szdiy/punch-tape-reader/README.md

# punch-tape-reader

1. /hardware - hardware design files
2. paper_tape_reader.ino - Arduino program for reading paper tape to keyboard

Refs: todo
