szdiy/punch-tape-reader/hardware/shell/1mm.dxf

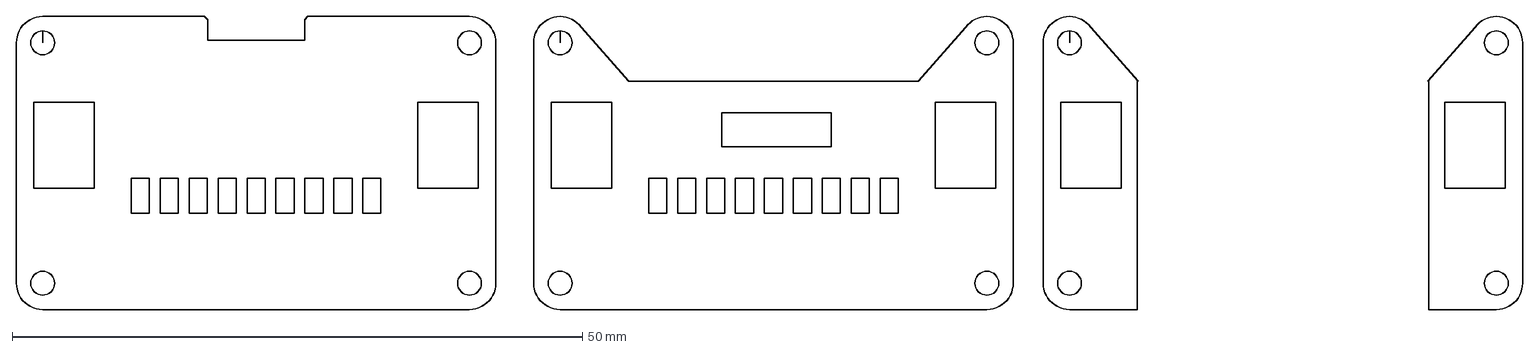
[picture p1: CAD file, 2024-11-14]
hardware/shell/1mm.dxf
132.1 x 25.7 mm
