szdiy/punch-tape-reader/(list of files, cad)

Other CAD files:
hardware/shell/1mm.dwg
