szdiy/punch-tape-reader/hardware/LEDshield.pdf

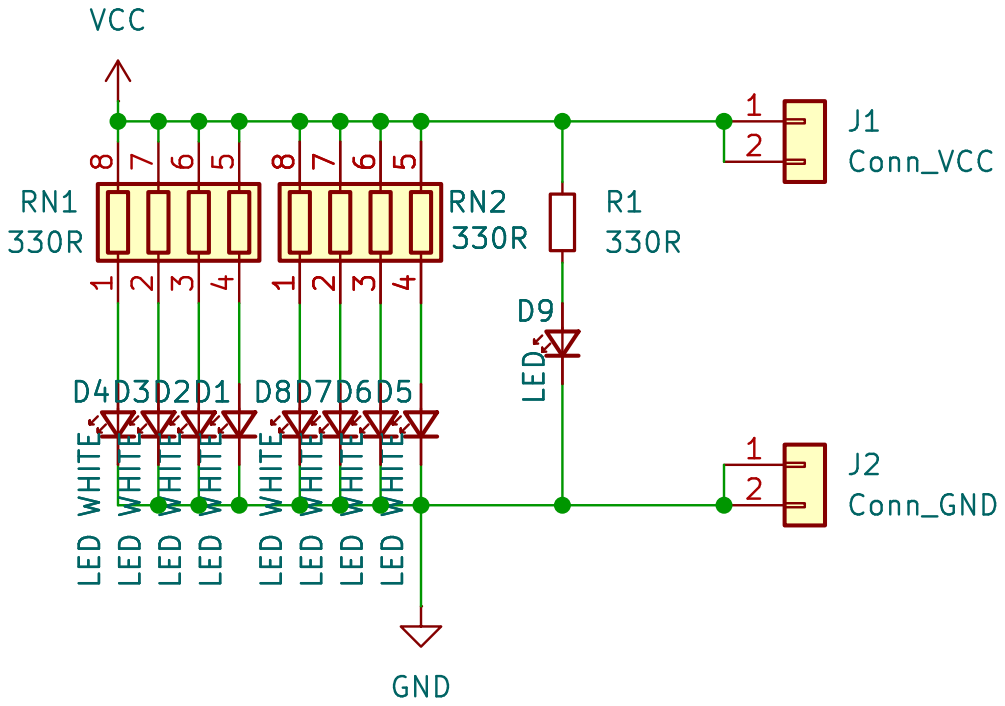
[picture p2: page 1]

5 D5LED WHITE D7LED WHITE D1LED WHITE D6LED WHITE D8LED WHITE D4LED WHITE D2LED WHITE D3LED WHITE

Id: 1/1 Title: File: LEDshield.kicad_sch Sheet: /
