szdiy/punch-tape-reader/hardware/ptr.pdf

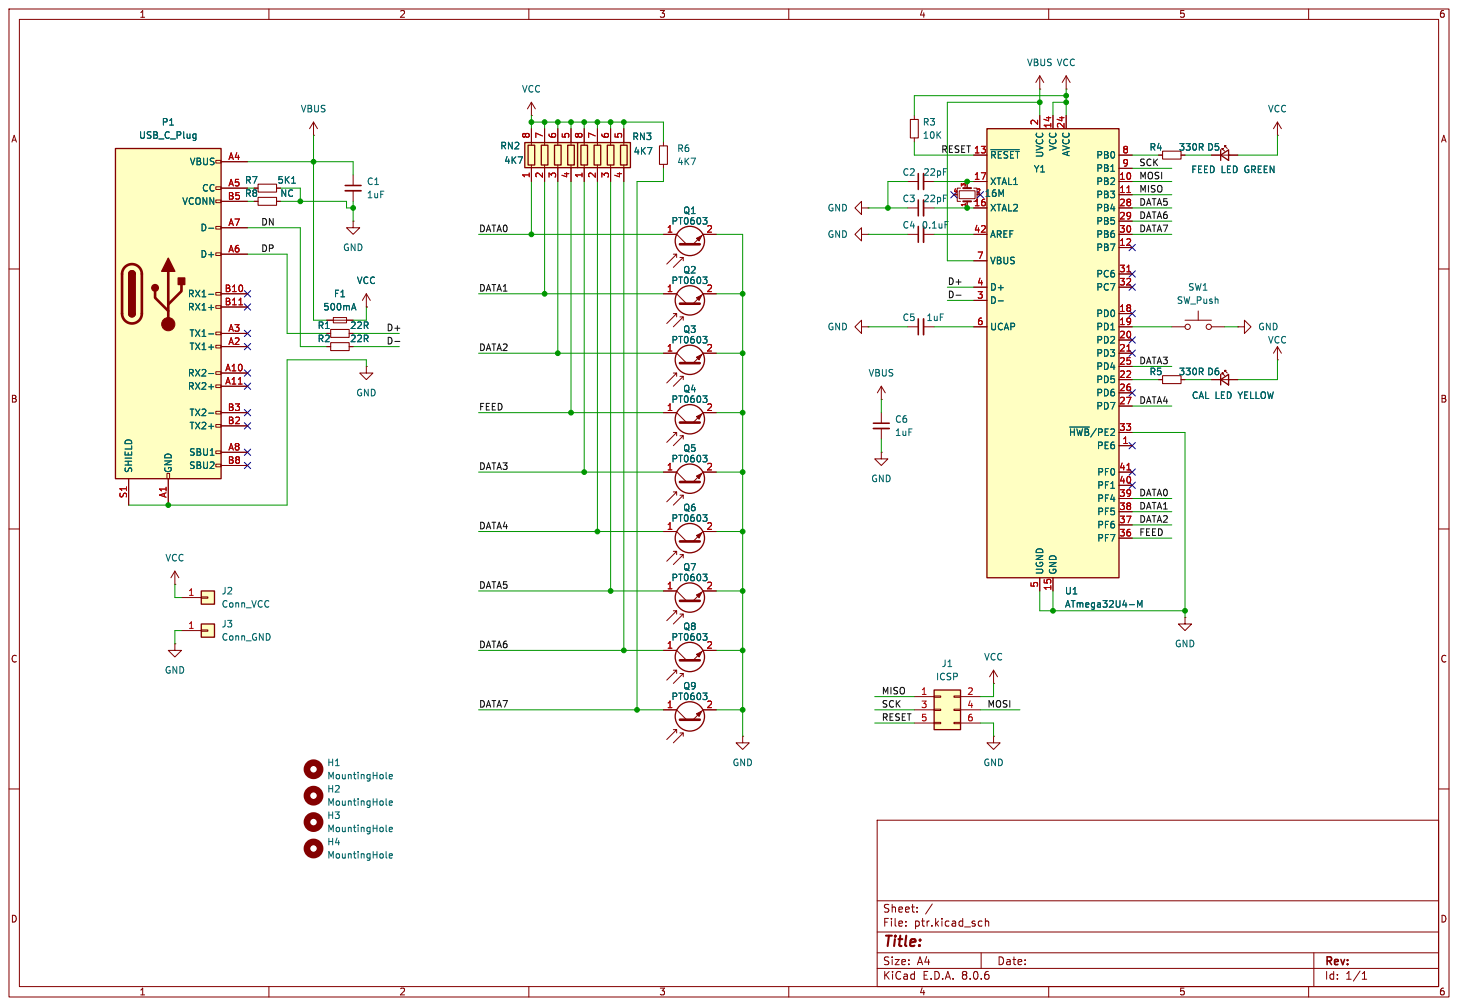
[picture p3: page 1]
