szdiy/punch-tape-reader/hardware/LEDshield.kicad_pcb

## KiCad design hardware/LEDshield.kicad_pcb (2024-11-14)

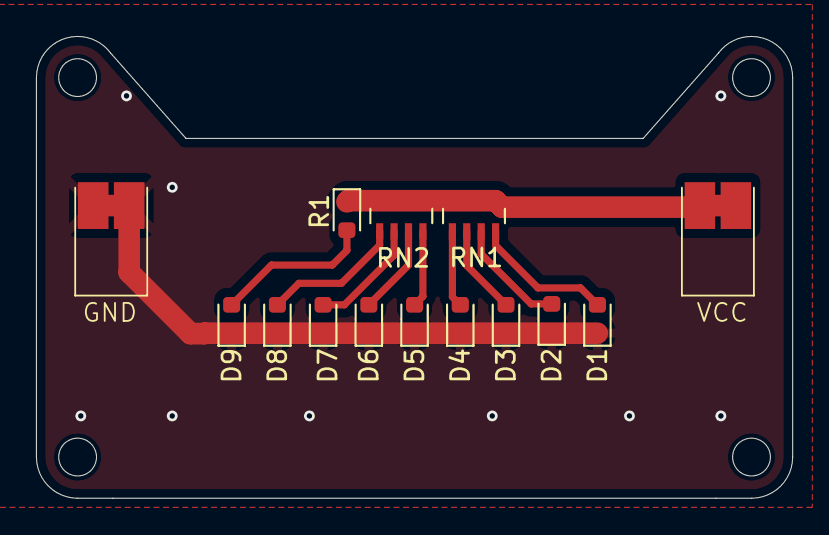
[picture p4: board LEDshield.kicad_pcb from above]

Board: 2 copper layers, 42.0 x 25.7 mm, 18 parts (0 on the bottom side), 11 nets.

Parts:
D1, D2, D3, D4, D5, D6, D7, D8, D9: LED; LED_0603_1608Metric
H1, H2, H3, H4: MountingHole; MountingHole_2.1mm
J1: Conn_VCC; 2pin
J2: Conn_GND; 2pin
R1: 330R; LED_0603_1608Metric
RN1, RN2: 330R; R_Array_Concave_4x0603

Connections:
GND: D1.1 (K), D2.1 (K), D3.1 (K), D4.1 (K), D5.1 (K), D6.1 (K), D7.1 (K), D8.1 (K), D9.1 (K), J2.1, J2.2
unnamed: D1.2 (A), RN1.4 (R4.1)
unnamed: D2.2 (A), RN1.3 (R3.1)
unnamed: D3.2 (A), RN1.2 (R2.1)
unnamed: D4.2 (A), RN1.1 (R1.1)
unnamed: D5.2 (A), RN2.4 (R4.1)
unnamed: D6.2 (A), RN2.3 (R3.1)
unnamed: D7.2 (A), RN2.2 (R2.1)
unnamed: D8.2 (A), RN2.1 (R1.1)
unnamed: D9.2 (A), R1.2
VCC: J1.1, J1.2, R1.1, RN1.5 (R4.2), RN1.6 (R3.2), RN1.7 (R2.2), RN1.8 (R1.2), RN2.5 (R4.2), RN2.6 (R3.2), RN2.7 (R2.2), RN2.8 (R1.2)
