szdiy/punch-tape-reader/hardware/ptr.kicad_pcb

## KiCad design hardware/ptr.kicad_pcb (2024-11-14)

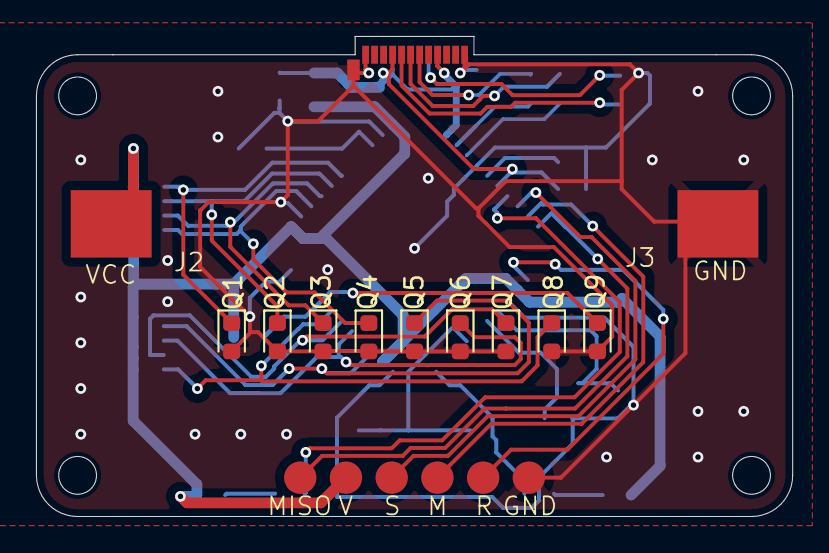
[picture p5: board ptr.kicad_pcb from above]

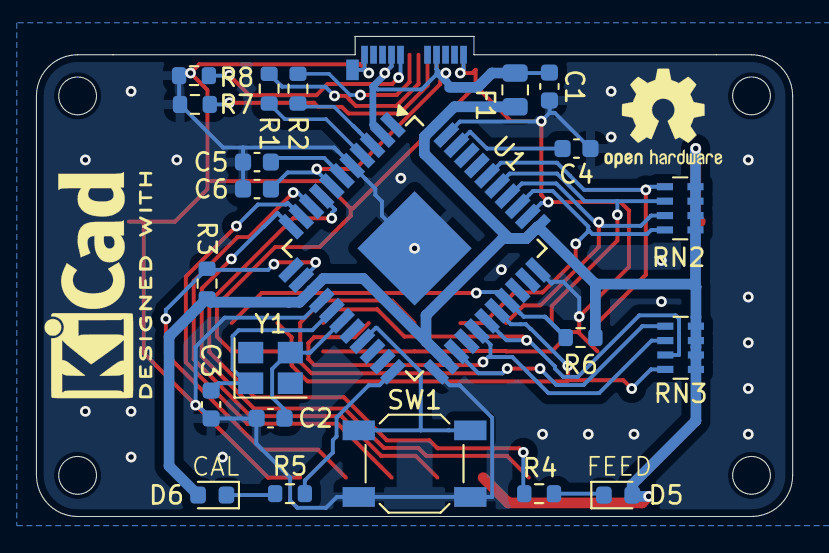
[picture p6: board ptr.kicad_pcb from below]

Board: 2 copper layers, 42.0 x 26.7 mm, 39 parts (22 on the bottom side), 31 nets.

Parts:
C1, C5, C6: 1uF; C_0603_1608Metric
C2, C3: 22pF; C_0603_1608Metric
C4: 0.1uF; C_0603_1608Metric
D5: FEED LED GREEN; LED_0603_1608Metric
D6: CAL LED YELLOW; LED_0603_1608Metric
F1: 500mA; Fuse_0805_2012Metric
H1, H2, H3, H4: MountingHole; MountingHole_2.1mm
J1: ICSP; testPoints 6pin
J2: Conn_VCC; 1pin
J3: Conn_GND; 1pin
P1: USB_C_Plug; USB_C_Plug_Molex_105444
Q1, Q2, Q3, Q4, Q5, Q6, Q7, Q8, Q9: BPW40; LED_0603_1608Metric
R1, R2: 22R; R_0603_1608Metric
R3: 10K; R_0603_1608Metric
R4, R5: 330R; R_0603_1608Metric
R6: 4K7; R_0603_1608Metric
R7: 5K1; R_0603_1608Metric
R8: NC; R_0603_1608Metric
RN2, RN3: 4K7; R_Array_Concave_4x0603
SW1: SW_Push; SW_SPST_SKQG_WithStem
U1: ATmega32U4-M; TQFP-44-1EP_10x10mm_P0.8mm_EP4.5x4.5mm
Y1: 16M; Crystal_SMD_3225-4Pin_3.2x2.5mm

Connections:
/D+: R1.2, U1.4 (D+)
/D-: R2.2, U1.3 (D-)
/DATA0: Q1.1 (C), RN2.1 (R1.1), U1.39 (PF4)
/DATA1: Q2.1 (C), RN2.2 (R2.1), U1.38 (PF5)
/DATA2: Q3.1 (C), RN2.3 (R3.1), U1.37 (PF6)
/DATA3: Q5.1 (C), RN3.1 (R1.1), U1.25 (PD4)
/DATA4: Q6.1 (C), RN3.2 (R2.1), U1.27 (PD7)
/DATA5: Q7.1 (C), RN3.3 (R3.1), U1.28 (PB4)
/DATA6: Q8.1 (C), RN3.4 (R4.1), U1.29 (PB5)
/DATA7: Q9.1 (C), R6.2, U1.30 (PB6)
/DN: P1.A7 (D-), R2.1
/DP: P1.A6 (D+), R1.1
/FEED: Q4.1 (C), RN2.4 (R4.1), U1.36 (PF7)
/MISO: J1.1, U1.11 (PB3)
/MOSI: J1.4, U1.10 (PB2)
/RESET: J1.5, R3.2, U1.13 (~RESET)
/SCK: J1.3, U1.9 (PB1)
GND: C1.2, C2.1, C3.1, C4.1, C5.1, C6.2, J1.6, J3.1, P1.A1 (GND), P1.A12 (GND), P1.B1 (GND), P1.B12 (GND), P1.S1 (SHIELD), Q1.2 (E), Q2.2 (E), Q3.2 (E), Q4.2 (E), Q5.2 (E), Q6.2 (E), Q7.2 (E), Q8.2 (E), Q9.2 (E), R7.2, R8.2, SW1.2, U1.5 (UGND), U1.15 (GND), U1.23 (GND), U1.33 (~HWB/PE2), U1.35 (GND), U1.43 (GND), U1.45 (GND)
unnamed: D5.1 (K), R4.2
unnamed: D6.1 (K), R5.2
unnamed: P1.A5 (CC), R7.1
unnamed: P1.B5 (VCONN), R8.1
unnamed: C4.2, U1.42 (AREF)
unnamed: R4.1, U1.8 (PB0)
unnamed: SW1.1, U1.19 (PD1)
unnamed: R5.1, U1.22 (PD5)
unnamed: C5.2, U1.6 (UCAP)
unnamed: C2.2, U1.17 (XTAL1), Y1.3
unnamed: C3.2, U1.16 (XTAL2), Y1.1
VBUS: C1.1, C6.1, F1.1, P1.A4 (VBUS), P1.A9 (VBUS), P1.B4 (VBUS), P1.B9 (VBUS), U1.2 (UVCC), U1.7 (VBUS)
VCC: D5.2 (A), D6.2 (A), F1.2, J1.2, J2.1, R3.1, R6.1, RN2.5 (R4.2), RN2.6 (R3.2), RN2.7 (R2.2), RN2.8 (R1.2), RN3.5 (R4.2), RN3.6 (R3.2), RN3.7 (R2.2), RN3.8 (R1.2), U1.14 (VCC), U1.24 (AVCC), U1.34 (VCC), U1.44 (AVCC)
