szdiy/punch-tape-reader/(commit log)

2024-11-01 copy from https://www.e-basteln.de/file/papertape/Paper_Tape_Reader.ino
2024-11-14 init code from danfei
    [1mm.dwg, 1mm.dxf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]
2024-11-14 change dir and update readme
    [1mm.dwg, 1mm.dxf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]
